virginiaclemente/Biodesign/README.md

# Biodesign
During the Biodesign course, my team and I developed a syringe infusion pump, a mechatronic device to control the flow rate of drug delivery.
