virginiaclemente/Biodesign/Desktop/Ingegneria Biomedica/ESAMI/Biodesign/GRUPPO_8/ATTACHMENT REPORT/Attachment_07.docx.pdf

# Siringability

∆P =

Q∙8∙η∙l
π∙R

4

Q = 0, 2

ml

s = 2∙10⁻⁷ m

3
s

Lmotor = τ∙ϑ

L

worm = F
worm
- ∆x

worm = P∙A∙pitcℎ∙n° tℎreads∙n° motor RPM

pitcℎ = 2mm

n° tℎreads = 4

n° motor RPM =

ϑ
2π
To assess whether the torque delivered by the motor is suitable to deliver the drug, we consider the following condition:

Lmotor ≥ L
worm

Lmotor = L

worm → τ∙ϑ = P∙A∙pitcℎ∙n° tℎreads∙

ϑ
2π
→ τ = P∙A∙pitcℎ∙n° tℎreads∙

1
2π

∙dissipative effect

A = π∙R

2 = π∙ 6. 5∙10

−3
( m)

2
= 1, 327∙10

−4
m

2

P = ∆P + P
vene
P

vene = 20 mmHg = 2666, 45 Pa

∆P = ∆P

syringe + ∆P

catℎeter + ∆P
needle
We consider water delivery:

η = 8, 9 * 10⁻⁴
Pa * s
1) Syringe Pressure:

R

syringe = 6, 5 mm = 6, 5∙10⁻³ m

l

syringe = 37. 67 mm = 37. 67∙10

−3
m

∆P

syringe =

Q∙8∙η∙l
π∙R

4 =

2∙10

−7 m

3
s

∙8∙8,9*10

−4
Pa*s∙37.67∙10

−3 m

π∙(6,5∙10

−3 m)

4 | = 9, 57∙10⁻³
Pa
2) Catheter Pressure:

R

catℎeter = 5 mm = 5∙10⁻³
m

l

catℎeter = 1, 5 m

∆P

catℎeter =

Q∙8∙η∙l
π∙R

4 =

2∙10

−7 m

3
s

∙8∙8,9*10

−4
Pa*s∙1,5 m

π∙ 5∙10

−3
( | m)
4 | = 1, 088 Pa
3) Needle (22GG) Pressure:

R

needle = 0. 7 mm = 0. 7∙10⁻³ m

l

needle = 32 mm = 32∙10

−3
m

∆P

needle =

Q∙8∙η∙l
π∙R

4 =

2∙10

−7 m

3
s

∙8∙8,9*10

−4
Pa*s∙32∙10

−3 m

π∙ 0.7∙10

−3
( | m)
4 | = 60, 411 Pa
∆P = ∆P | =

syringe + ∆P

catℎeter + ∆P

| needle 9, 57∙10

−3
Pa + 1, 088 Pa + 60, 411 Pa = 61, 51 Pa

P = ∆P + P

| vene = 61, 51 Pa + 2666, 45 Pa = 2727, 96 Pa

τ = P∙A∙step∙n° tℎreads∙

1
| 2π = 2727, 96 Pa∙1, 327∙10

−4
m

2
∙2∙10

−3
m∙4∙

1
2π = 4, 6∙10

−4 Nm

vmotore = micro_stepping number ∙

Q
A = 2∙

2∙

10

−7m

3
s
π* 6,5 ∙10

−3

( m) 2 = 3. 014∙10

−3 m
s = 3. 014

mm
s
v | 7,2 rpm = 0.12 rps motore_RPM = vmotore
•

30
π

•

1
R
worm

= 3. 014∙10⁻³ m
| s

•

30
π

•

1
4∙10

−3 m

=
= 48 pps

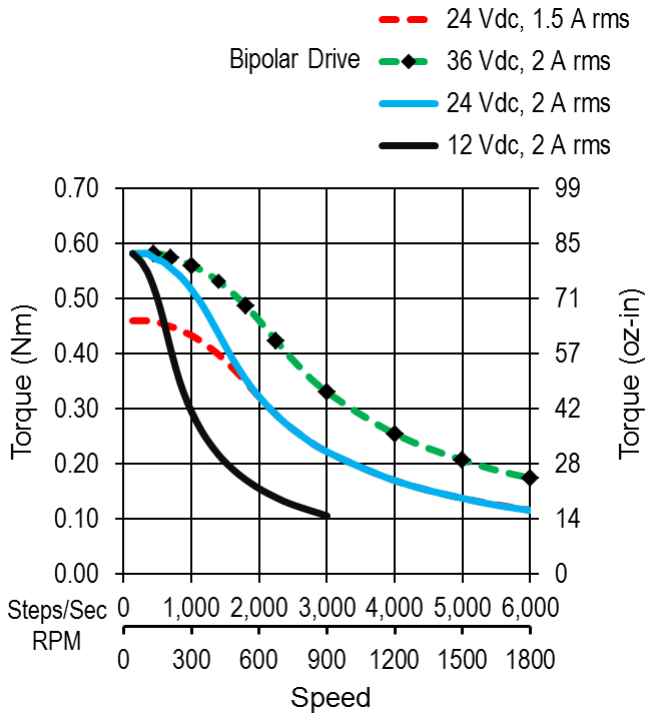
[picture p22: figure]

For a velocity of 7,2 rpm, from the graph we can observe a torque approximately equal to the maximum torque (0.59 Nm). The torque obtained for our application (4, 6∙10 ) is less than ⁻⁴ Nm

the maximum torque that can be delivered by the motor at this speed.

This demonstration can be applied to any drug that has the same rheological properties as water.

We calculate the torque that the motor must generate to allow the drug to be injected into the vein, considering increasing flows:

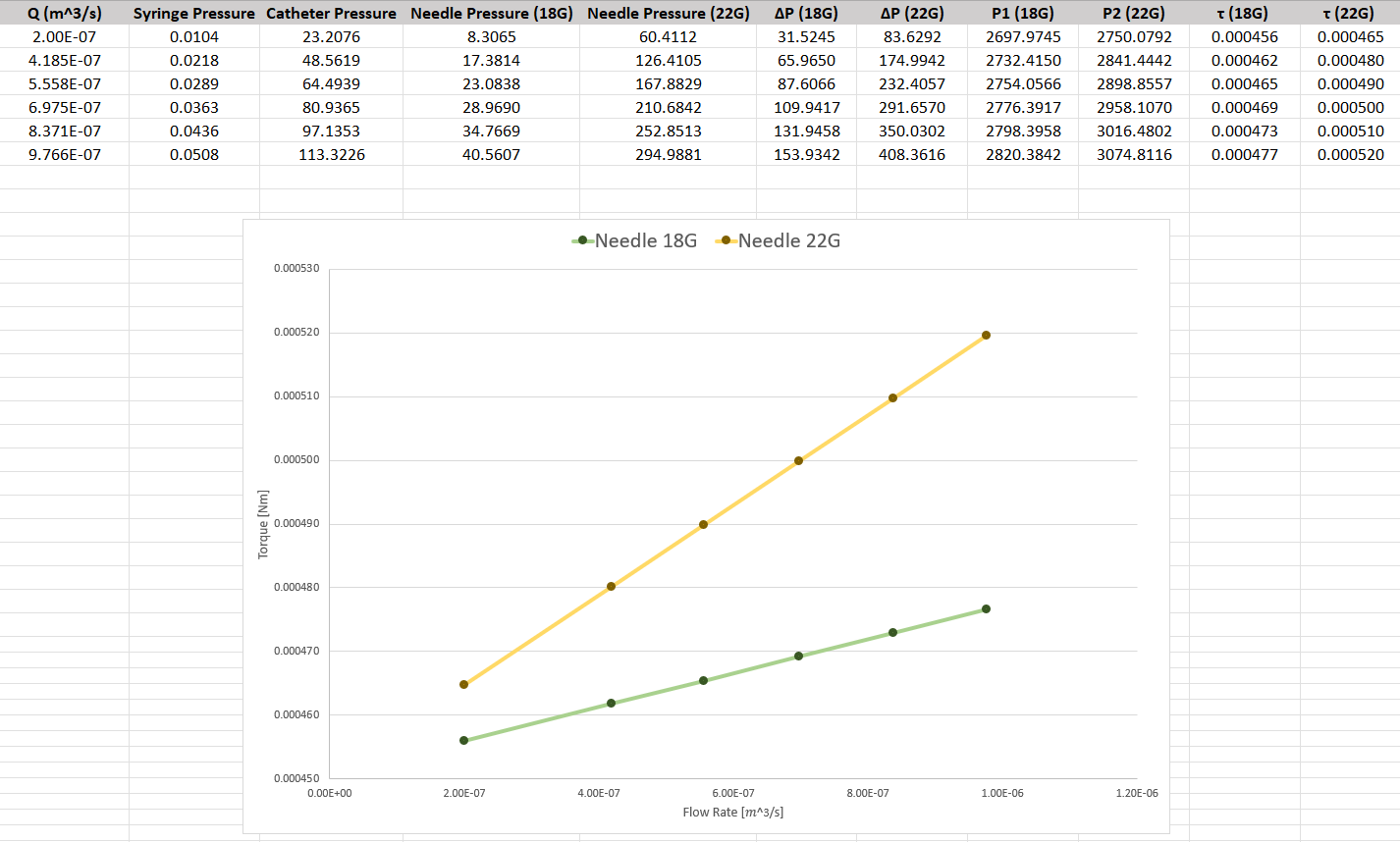
[picture p23: figure]

Two types of needles are evaluated in detail:

Needle 18G

- Needle radius: 1.2 mm
- Needle length: 38 mm

P

needle1 =

Q∙8∙η∙l
ago1
π∙(R
ago1

)

4

Needle 22G

- Needle radius: 0.7 mm
- Needle length: 32 mm

P

needle2 =

Q∙8∙η∙l
ago2
π∙(R
ago2

)

4

Working conditions:

τmotor < τmotormax

= 0. 59 Nm

τ = P∙A∙step∙n° tℎreads∙

1
2π < τmotormax

P <

τmotormax

•2π

A∙step∙n° tℎreads
P = ∆P + P
veins

∆P + P

veins <

τmotormax

•2π

A∙step∙n° tℎreads

∆P <

τmotormax

•2π
A∙step∙n° tℎreads − P
veins
∆P = ∆P

syringe + ∆P

catℎeter + ∆P
needle
We determine a relationship to determine the size of the needle to be used in our application:

∆P

needle <

τmotormax

•2π
A∙step∙n° tℎreads − P

veins − ∆P

syringe − ∆P
catℎeter

∆P

needle =

Q∙8∙η∙l
π∙R

4

l
R

4 <

π∙(

τmotormax

•2π
A∙step∙n° tℎreads −P

veins−∆P

syringe−∆P
catℎeter

)
Q∙8∙η

We determine a relationship to establish the allowable viscosity value:

∆P = η

Q∙8∙l
s
π∙R
s

4 +

Q∙8∙l
c
π∙R
c

4 +

Q∙8∙l
n
π∙R
n

( 4 ) <
τmotormax

•2π
A∙step∙n° tℎreads − P
veins

η <

τmotormax

•2π
A∙step∙n° tℎreads −P
veins

Q∙8∙l
s
π∙R
s

4 +

Q∙8∙l
c
π∙R
c

4 +

Q∙8∙l
n
π∙R
n

( 4 )
