virginiaclemente/Biodesign/Desktop/Ingegneria Biomedica/ESAMI/Biodesign/GRUPPO_8/ATTACHMENT REPORT/Attachment_07.xlsx

Q (m^3/s) | Syringe Pressure | Catheter Pressure | Needle Pressure (18G) | Needle Pressure (22G) | ∆P (18G) | ∆P (22G) | P1 (18G) | P2 (22G) | τ (18G) | τ (22G)
2e-07 | 0.0104 | 23.2076 | 8.3065 | 60.4112 | 31.5245 | 83.6292 | 2697.9745 | 2750.0792 | 0.000456 | 0.000465
4.185e-07 | 0.0218 | 48.5619 | 17.3814 | 126.4105 | 65.9650 | 174.9942 | 2732.4150 | 2841.4442 | 0.000462 | 0.000480
5.558e-07 | 0.0289 | 64.4939 | 23.0838 | 167.8829 | 87.6066 | 232.4057 | 2754.0566 | 2898.8557 | 0.000465 | 0.000490
6.975e-07 | 0.0363 | 80.9365 | 28.9690 | 210.6842 | 109.9417 | 291.6570 | 2776.3917 | 2958.1070 | 0.000469 | 0.000500
8.371e-07 | 0.0436 | 97.1353 | 34.7669 | 252.8513 | 131.9458 | 350.0302 | 2798.3958 | 3016.4802 | 0.000473 | 0.000510
9.766e-07 | 0.0508 | 113.3226 | 40.5607 | 294.9881 | 153.9342 | 408.3616 | 2820.3842 | 3074.8116 | 0.000477 | 0.000520
