virginiaclemente/Biodesign/(list of files, cad)

Other CAD files:
Desktop/Ingegneria Biomedica/ESAMI/Biodesign/GRUPPO_8/REPORT_flussimetro v17.f3d
