virginiaclemente/Biodesign/Desktop/Ingegneria Biomedica/ESAMI/Biodesign/GRUPPO_8/REPORT_flussimetro.brd

## EAGLE design Desktop/Ingegneria Biomedica/ESAMI/Biodesign/GRUPPO_8/REPORT_flussimetro.brd (2024-03-01)

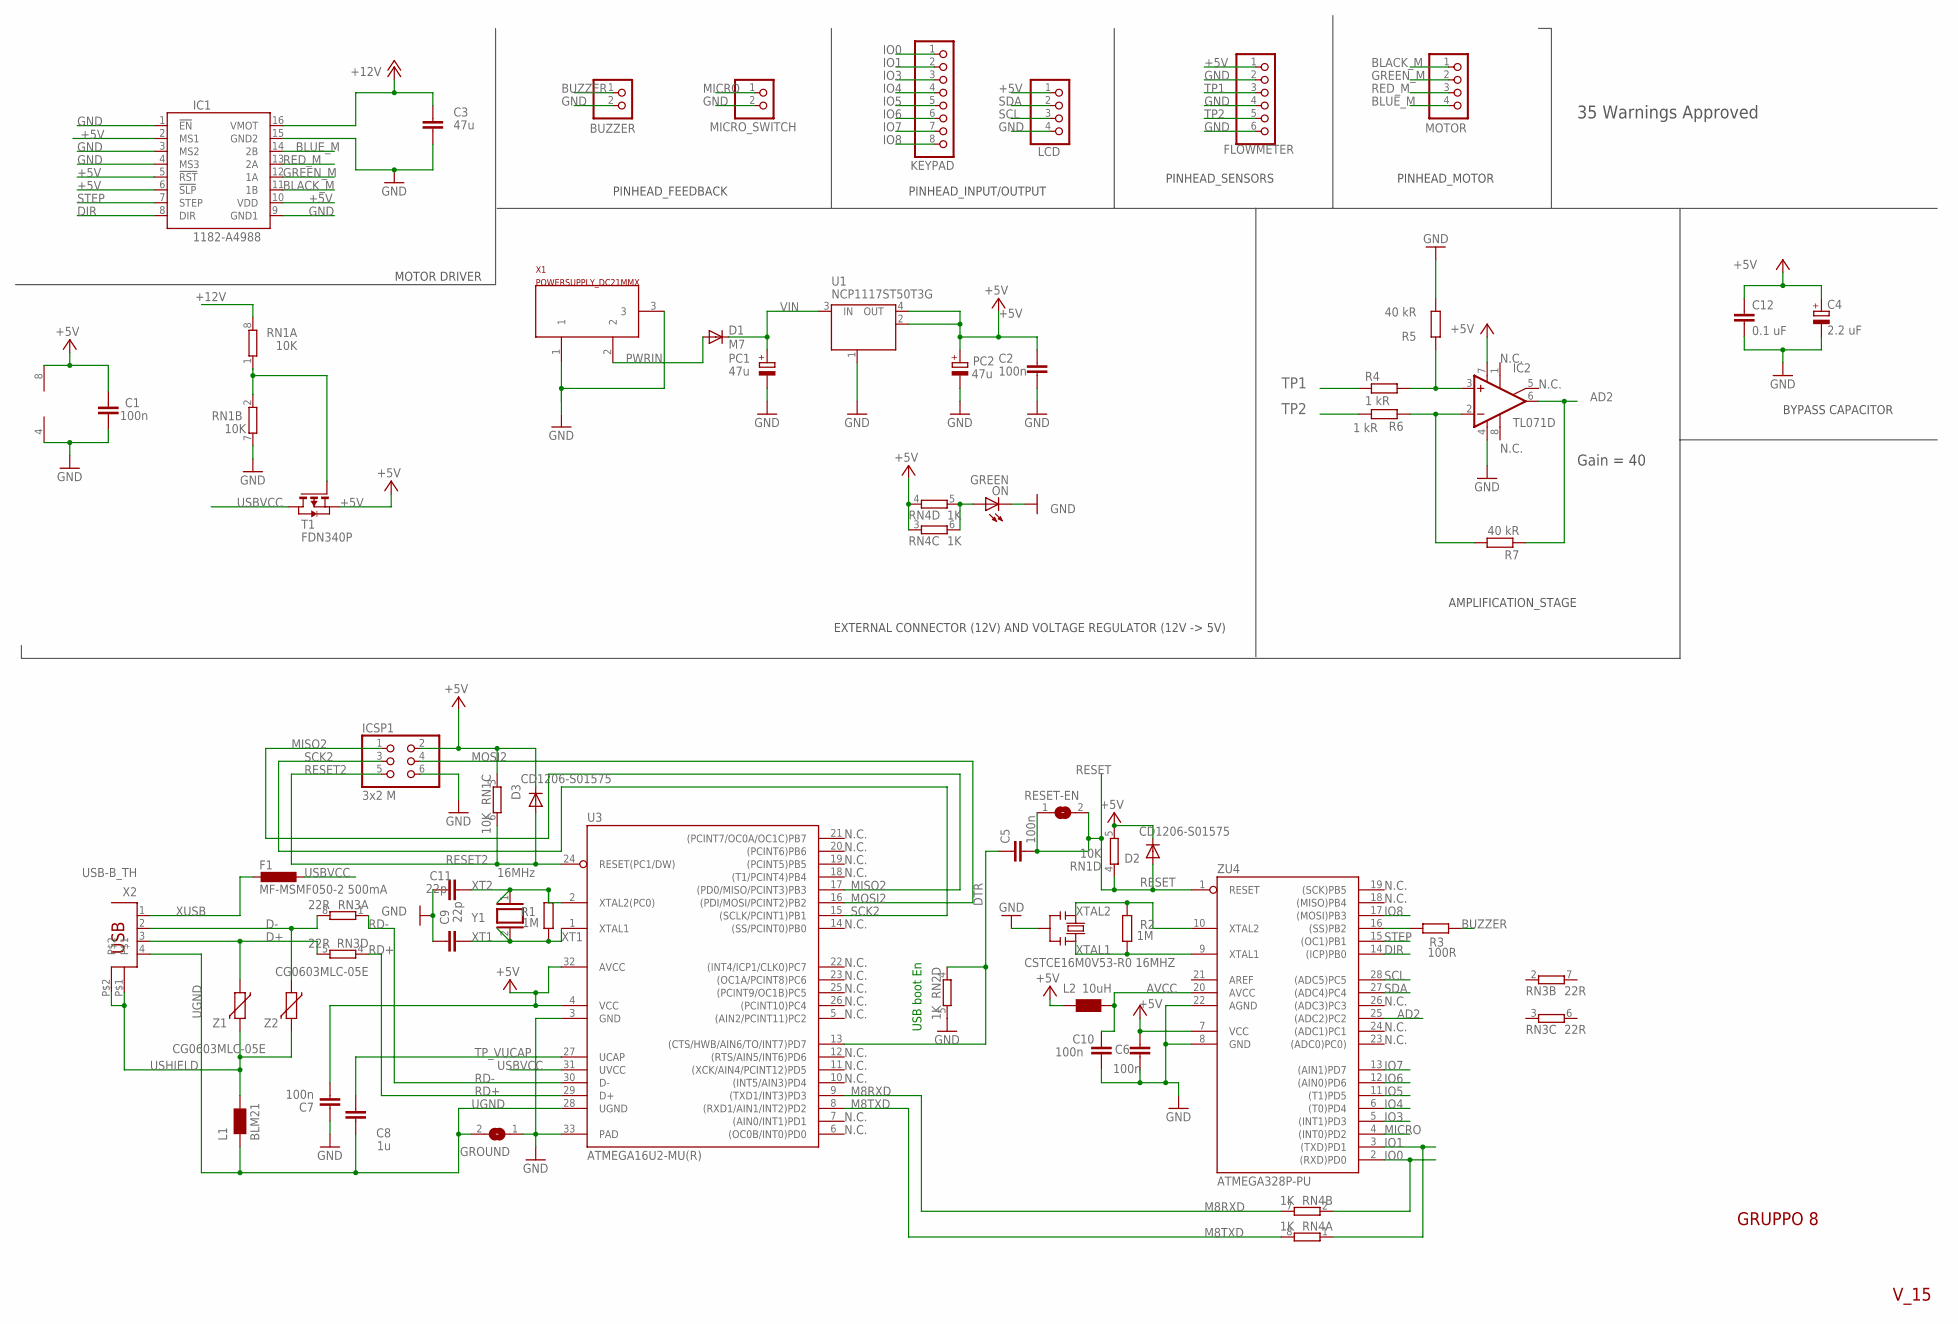
[picture p33: schematic REPORT_flussimetro.sch]

Parts:
BUZZER: PINHD-1X2; 1X02; MPN 826926-2
C1, C2, C5, C6, C7, C10: 100n; C0603-ROUND; MPN 4550-10
C3: 47u; C0603; MPN GRM188R60J476ME15D
C4: 2.2 uF; A/3216-18R; MPN TAJA225K016RNJ
C8: 1u; C0603-ROUND; MPN C1608X5R1C105K080AA
C9, C11: 22p; C0603-ROUND; MPN 06035A220FAT2A
C12: 0.1 uF; C0603; MPN 0603YC104KAT2A
D1: M7; SMB; MPN S1M-13-F
D2, D3: CD1206-S01575; MINIMELF; MPN CD1206-S01575
F1: MF-MSMF050-2 500mA; L1812; MPN MF-MSMF050-2
FLOWMETER: PINHD-1X6; 1X06; MPN 2211S-06G
GROUND: SJ
IC1: 1182-A4988; A4988
IC2: TL071D; SO08; MPN LT1211CS8#TRPBF
ICSP1: 3x2 M; 2X03; MPN 87758-0616
KEYPAD: PINHD-1X8; 1X08; MPN 2211S-08G
L1: BLM21; 0805; MPN BLM21SP471BH1D
L2: 10uH; 0805; MPN CV201210-100K
LCD: PINHD-1X4; 1X04; MPN 826926-4
MICRO_SWITCH: PINHD-1X2; 1X02; MPN 826926-2
MOTOR: PINHD-1X4; 1X04; MPN 826926-4
ON: GREEN; CHIP-LED0805; MPN KP-1608SGC
PC1, PC2: 47u; PANASONIC_D; MPN EEE1EA470WP
R1, R2: 1M; R0603-ROUND; MPN CRGH0603J1M0
R3: 100R; R0603; MPN ERJPA3F1000V
R4, R6: 1 kR; R0603; MPN CPF0603B1K0E1
R5, R7: 40 kR; R0603; MPN AT0603BRD0740KL
RESET-EN: SJ
RN1: 10K; CAY16; MPN CAY16-1002F4LF
RN2, RN4: 1K; CAY16; MPN CAY16-102J4LF
RN3: 22R; CAY16; MPN CAY16-220J4LF
T1: FDN340P; SOT-23; MPN FDN340P
U1: NCP1117ST50T3G; SOT223; MPN NCP1117ST50T3G
U3: ATMEGA16U2-MU(R); MLF32; MPN ATMEGA16U2-MUR
U5: LMV358IDGKR; MSOP08; MPN LMV358LIST
X1: POWERSUPPLY_DC21MMX; POWERSUPPLY_DC-21MM; MPN 1613 21
X2: USB-B_TH; PN61729; MPN SPC4937
Y1: 16MHz; QS; MPN ECS-160-20-4X
Y2: CSTCE16M0V53-R0 16MHZ; RESONATOR; MPN CSTNE16M0V51C000R0
Z1, Z2: CG0603MLC-05E; CT/CN0603; MPN CG0603MLC-05E
ZU4: ATMEGA328P-PU; DIL28-3; MPN ATMEGA328P-PU

Connections:
+5V: C1.2, C2.2, C4.+, C6.2, C7.1, C12.1, D2.C, D3.C, FLOWMETER.1, IC1.2 (MS1), IC1.5 (!RST), IC1.6 (!SLP), IC1.10 (VDD), IC2.7 (V+), ICSP1.2, L2.1, LCD.1, PC2.+, RN1.1, RN1.2 (1), RN1.3 (1), RN1.5 (2), RN4.3 (1), RN4.4 (1), T1.2 (S), T1.3 (G), U1.2 (OUT), U1.4 (OUT), U3.4 (VCC), U3.32 (AVCC), U5.8 (V+), ZU4.7 (VCC)
+12V: C3.1, IC1.16 (VMOT), RN1.8 (2)
AD2: IC2.6 (OUT), R7.1, ZU4.25 ((ADC2)PC2)
AVCC: C10.2, L2.2, ZU4.20 (AVCC)
BLACK_M: IC1.11 (1B), MOTOR.1
BLUE_M: IC1.14 (2B), MOTOR.4
BUZZER: BUZZER.1, R3.2
D+: RN3.5 (2), X2.3, Z1.1
D-: RN3.8 (2), X2.2, Z2.1
DIR: IC1.8 (DIR), ZU4.14 ((ICP)PB0)
DTR: C5.1, RN2.4 (1), U3.13 ((CTS/HWB/AIN6/TO/INT7)PD7)
GND: BUZZER.2, C1.1, C2.1, C3.2, C4.-, C6.1, C7.2, C9.2, C10.1, C11.2, C12.2, FLOWMETER.2, FLOWMETER.4, FLOWMETER.6, GROUND.1, IC1.1 (!EN), IC1.3 (MS2), IC1.4 (MS3), IC1.9 (GND1), IC1.15 (GND2), IC2.4 (V-), ICSP1.6, LCD.4, MICRO_SWITCH.2, ON.C, PC1.-, PC2.-, R5.2, RN1.7 (2), RN2.5 (2), U1.1 (GND/ADJ), U3.3 (GND), U3.33 (PAD), U5.4 (V-), X1.1, X1.3, Y2.2, ZU4.8 (GND), ZU4.22 (AGND)
GREEN_M: IC1.12 (1A), MOTOR.2
IO0: KEYPAD.1, RN4.2 (1), ZU4.2 ((RXD)PD0)
IO1: KEYPAD.2, RN4.1, ZU4.3 ((TXD)PD1)
IO3: KEYPAD.3, ZU4.5 ((INT1)PD3)
IO4: KEYPAD.4, ZU4.6 ((T0)PD4)
IO5: KEYPAD.5, ZU4.11 ((T1)PD5)
IO6: KEYPAD.6, ZU4.12 ((AIN0)PD6)
IO7: KEYPAD.7, ZU4.13 ((AIN1)PD7)
IO8: KEYPAD.8, ZU4.17 ((MOSI)PB3)
IO16: R3.1, ZU4.16 ((SS)PB2)
M8RXD: RN4.7 (2), U3.9 ((TXD1/INT3)PD3)
M8TXD: RN4.8 (2), U3.8 ((RXD1/AIN1/INT2)PD2)
MICRO: MICRO_SWITCH.1, ZU4.4 ((INT0)PD2)
MISO2: ICSP1.1, U3.17 ((PD0/MISO/PCINT3)PB3)
MOSI2: ICSP1.4, U3.16 ((PDI/MOSI/PCINT2)PB2)
unnamed: IC2.2 (-IN), R6.1, R7.2
unnamed: IC2.3 (+IN), R4.2, R5.1
unnamed: ON.A, RN4.5 (2), RN4.6 (2)
PWRIN: D1.A, X1.2
RD+: RN3.4 (1), U3.29 (D+)
RD-: RN3.1, U3.30 (D-)
RED_M: IC1.13 (2A), MOTOR.3
RESET: C5.2, D2.A, RESET-EN.1, RESET-EN.2, RN1.4 (1), ZU4.1 (RESET)
RESET2: D3.A, ICSP1.5, RN1.6 (2), U3.24 (RESET(PC1/DW))
SCK2: ICSP1.3, U3.15 ((SCLK/PCINT1)PB1)
SCL: LCD.3, ZU4.28 ((ADC5)PC5)
SDA: LCD.2, ZU4.27 ((ADC4)PC4)
STEP: IC1.7 (STEP), ZU4.15 ((OC1)PB1)
TP1: FLOWMETER.3, R4.1
TP2: FLOWMETER.5, R6.2
TP_VUCAP: C8.1, U3.27 (UCAP)
UGND: C8.2, GROUND.2, L1.1, U3.28 (UGND), X2.4
USBVCC: F1.1, T1.1 (D), U3.31 (UVCC)
USHIELD: L1.2, X2.P$1, X2.P$2, Z1.2, Z2.2
VIN: D1.C, PC1.+, U1.3 (IN)
XT1: C9.1, R1.1, U3.1 (XTAL1), Y1.2
XT2: C11.1, R1.2, U3.2 (XTAL2(PC0)), Y1.1
XTAL1: R2.1, Y2.3, ZU4.9 (XTAL1)
XTAL2: R2.2, Y2.1, ZU4.10 (XTAL2)
XUSB: F1.2, X2.1

Notes on the sheet:
USB boot En
GRUPPO 8
V_15
MOTOR DRIVER
PINHEAD_FEEDBACK
PINHEAD_INPUT/OUTPUT
PINHEAD_SENSORS
PINHEAD_MOTOR
EXTERNAL CONNECTOR (12V) AND VOLTAGE REGULATOR (12V -> 5V)
N.C.
35 Warnings Approved
AMPLIFICATION_STAGE
Gain = 40
BYPASS CAPACITOR

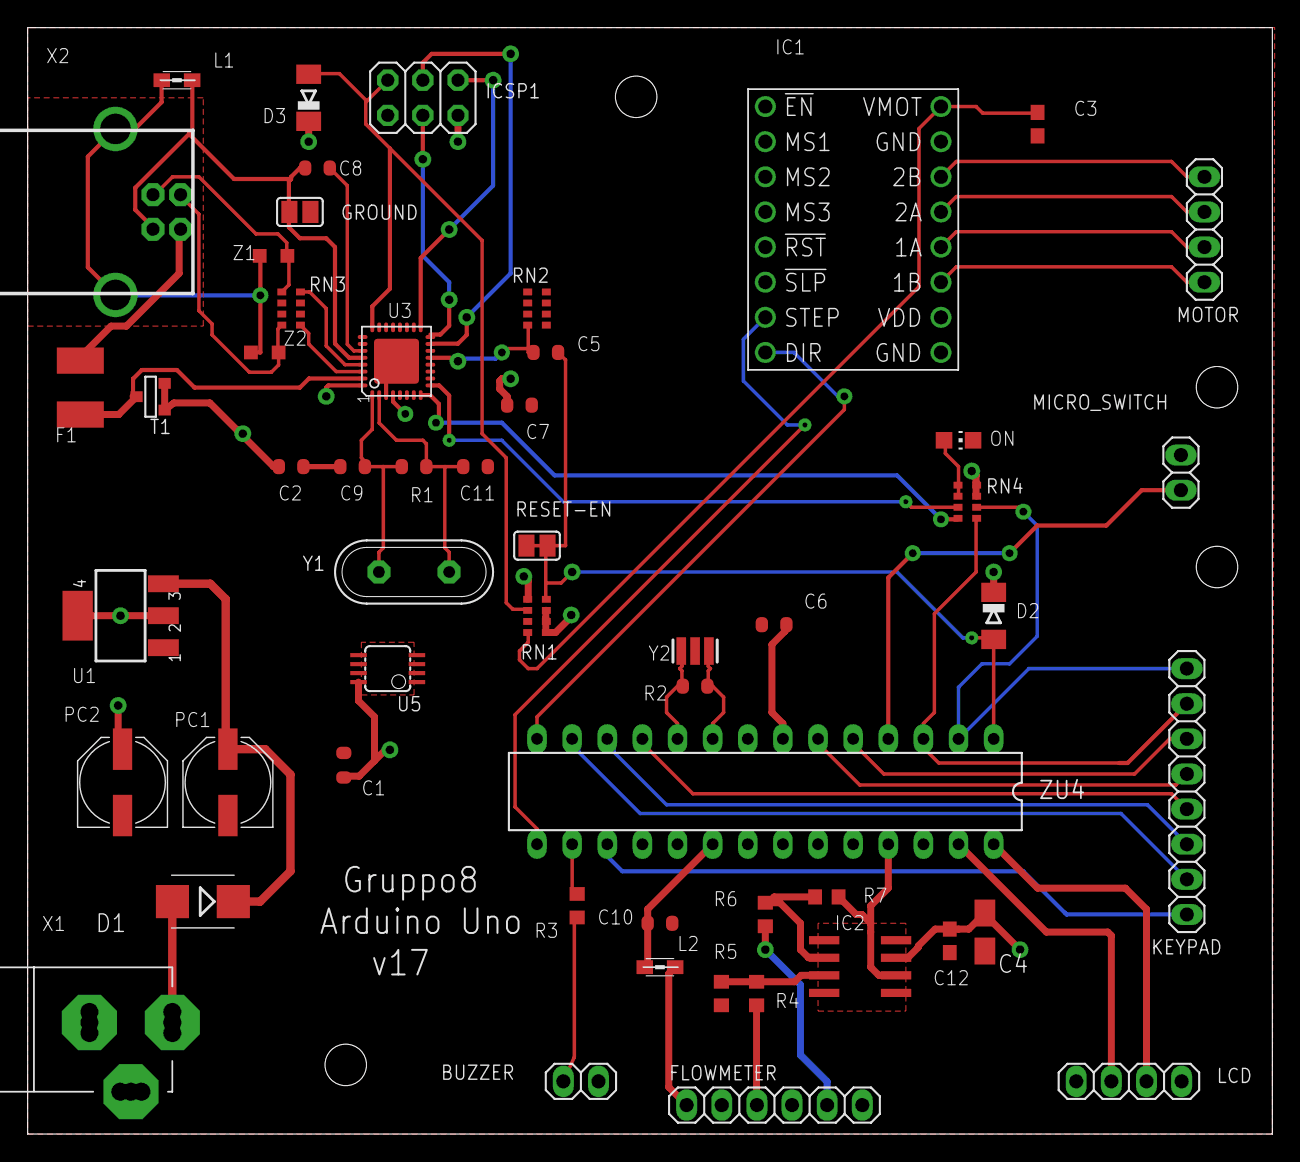
[picture p34: board REPORT_flussimetro.brd from above]

Board: 2 copper layers, 90.0 x 80.0 mm, 54 parts (0 on the bottom side), 52 nets.
